EzraBel/BattleBotsFinal/Blank diagram (2).pdf

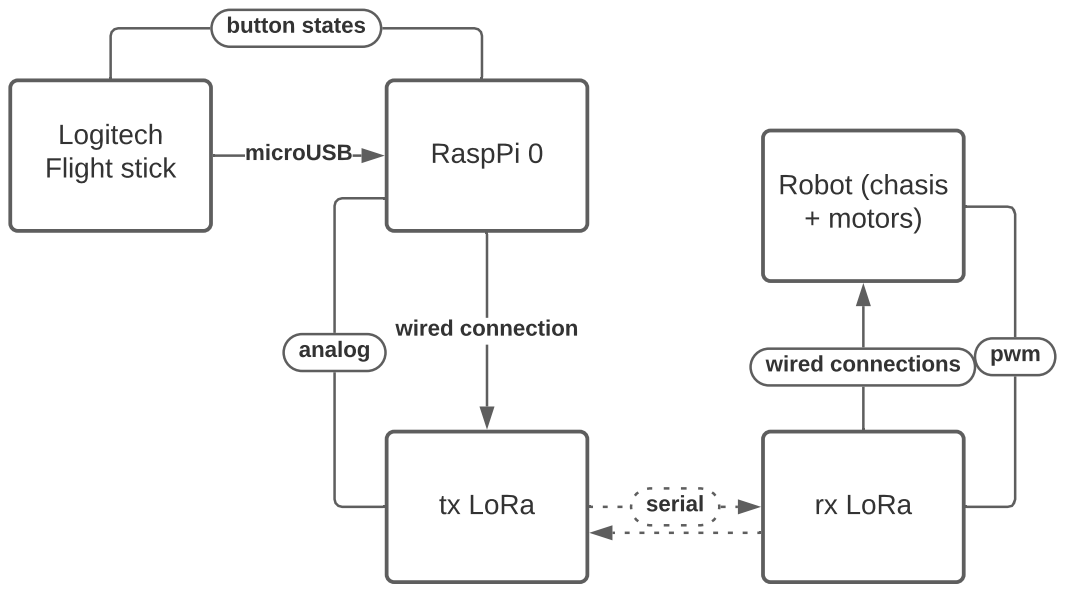
[picture p1: page 1]
Logitech; Flight stick; microUSB; RaspPi 0; tx LoRa; rx LoRa; wired connection; serial; Robot (chasis + motors); wired connections; button states; analog; pwm
